nicolacimmino/BicycleBrakeLight/(threads)

Thread 2 (2017-11-12):

Unable to find a single MMA7361

arduibag, 2017-11-12:
Hello,

I would like to recreate your Bicycle Brake project on my Arduibag (www.arduibag.com) but I can't find the same MMA7361 module as yours (It's not sold anymore!).

It doesn't seem to work with this type of module and your unmodified code:
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

The advantage of this one is that it is supplied with a library with an automatic calibration mode... Can you help me adapt your code ?

DAquad, 2022-10-10:
Could you find a solution? I'm finding the same problem.
Got the above MMA7631 and code is not working unfortunately.

Thread 3 (2022-10-10):

Code is not working

DAquad, 2022-10-10:
Hello,

I tried to build the Tail brake light following your code.
I'm using Arduino Nano and MMA7631 Acc.

Wired the acc. to Arduino Pins
Z--->A0
Y-->A2
X-->A1
5v-->D13
GND-->A3

Checked the Serial port and Im not getting data.

Checked the mma7631  acc. with a different testing code is working perfectly.
What do you suggest?

Cheers
