nicolacimmino/BicycleBrakeLight/(commit log)

2014-08-15 Added calibration of all axes
2014-08-16 Tuned running average low pass frequency to roughly 0.8Hz
2014-08-16 Added running average filter response formula
2014-08-16 Added running average filter response plot
2014-08-16 Added prototype picture
2014-08-17 Change to FIR filter
2014-08-17 Added FIR filter response curve
2014-08-17 Resized FIR filter response picture
2014-08-17 Better FIR filter
2014-08-18 Fixed wrong convolution in FIR filter
    [TailLight.ino]
2014-08-19 More flat filter and added hysteresis
2014-08-22 Changed to IIR filter and added filter to separate gravity
2014-08-23 Fixed wrong IIR filter implementation and factored gravity into resul
    [TailLight.ino]
2014-08-24 Adjusted pins for new assembly orientation
